kr397/ece4760-AroundSound/docs/images/parts_list.jpg

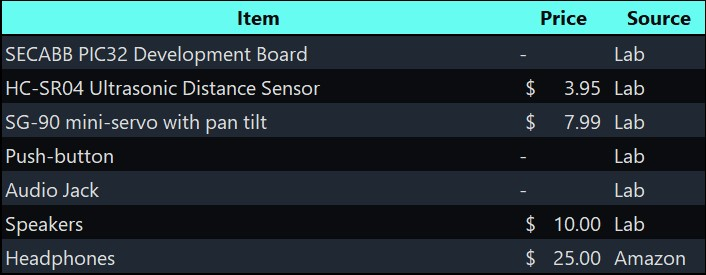
docs/images/parts_list.jpg
