kr397/ece4760-AroundSound/docs/images/form-factor.jpg

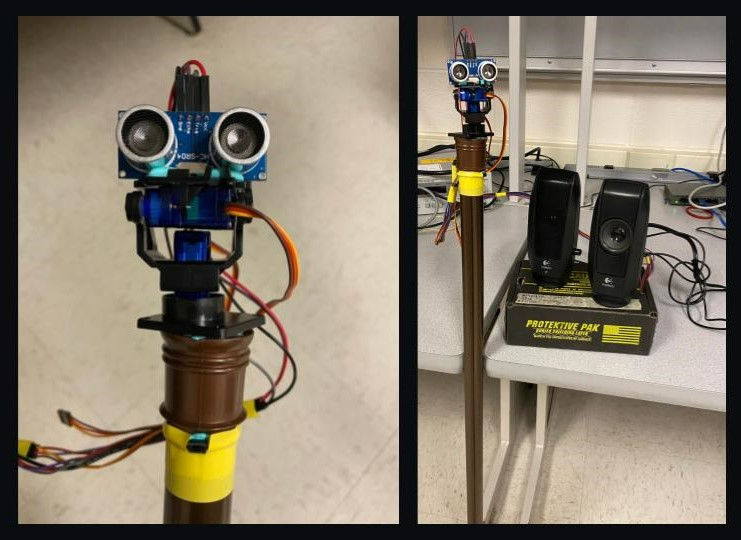
docs/images/form-factor.jpg
