kr397/ece4760-AroundSound/docs/images/3d audio.png

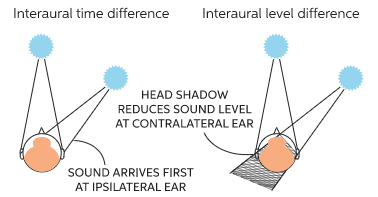
docs/images/3d audio.png
