kr397/ece4760-AroundSound/docs/images/FM_envelope.png

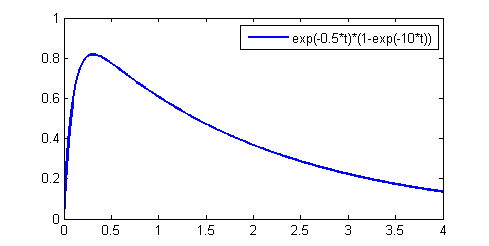
docs/images/FM_envelope.png
