kr397/ece4760-AroundSound/docs/images/Gradient.jpg

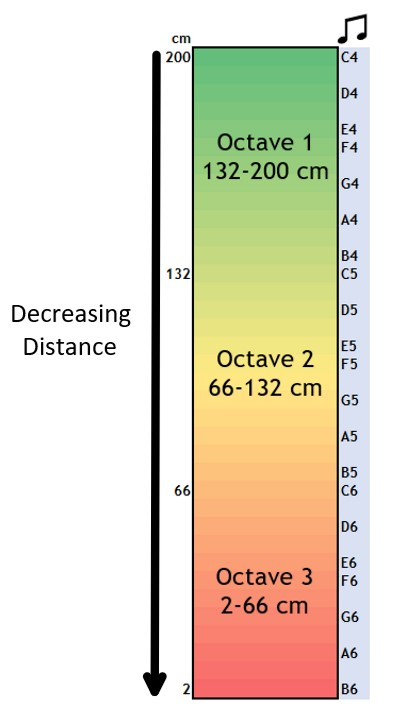
docs/images/Gradient.jpg
