kr397/ece4760-AroundSound/docs/images/pwm_motor.jpg

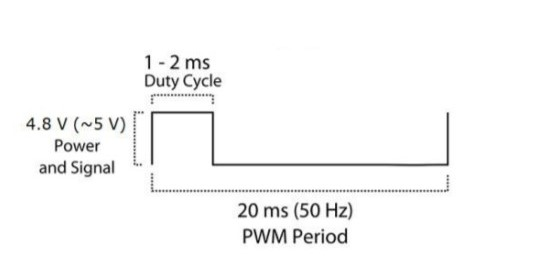
docs/images/pwm_motor.jpg
