kr397/ece4760-AroundSound/docs/images/stick-full.jpg

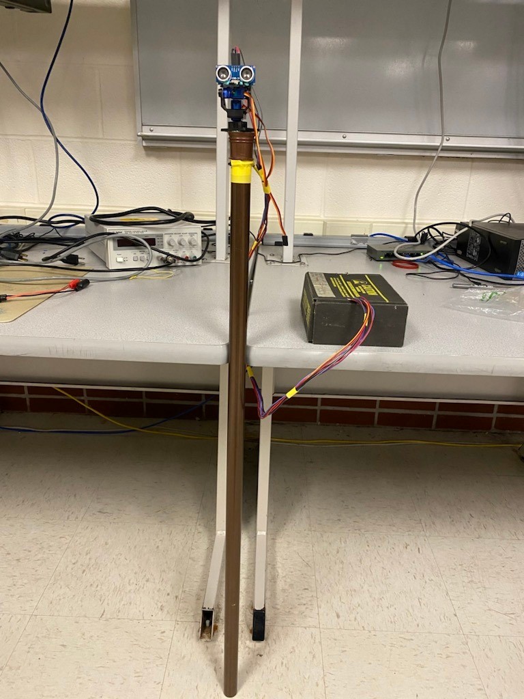
docs/images/stick-full.jpg
