kr397/ece4760-AroundSound/docs/images/timeline.png

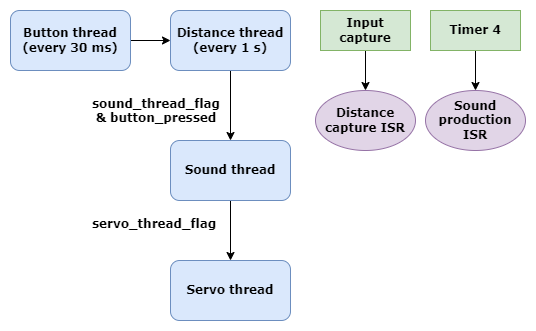
docs/images/timeline.png
