kr397/ece4760-AroundSound/docs/Circuit_schematic.pdf

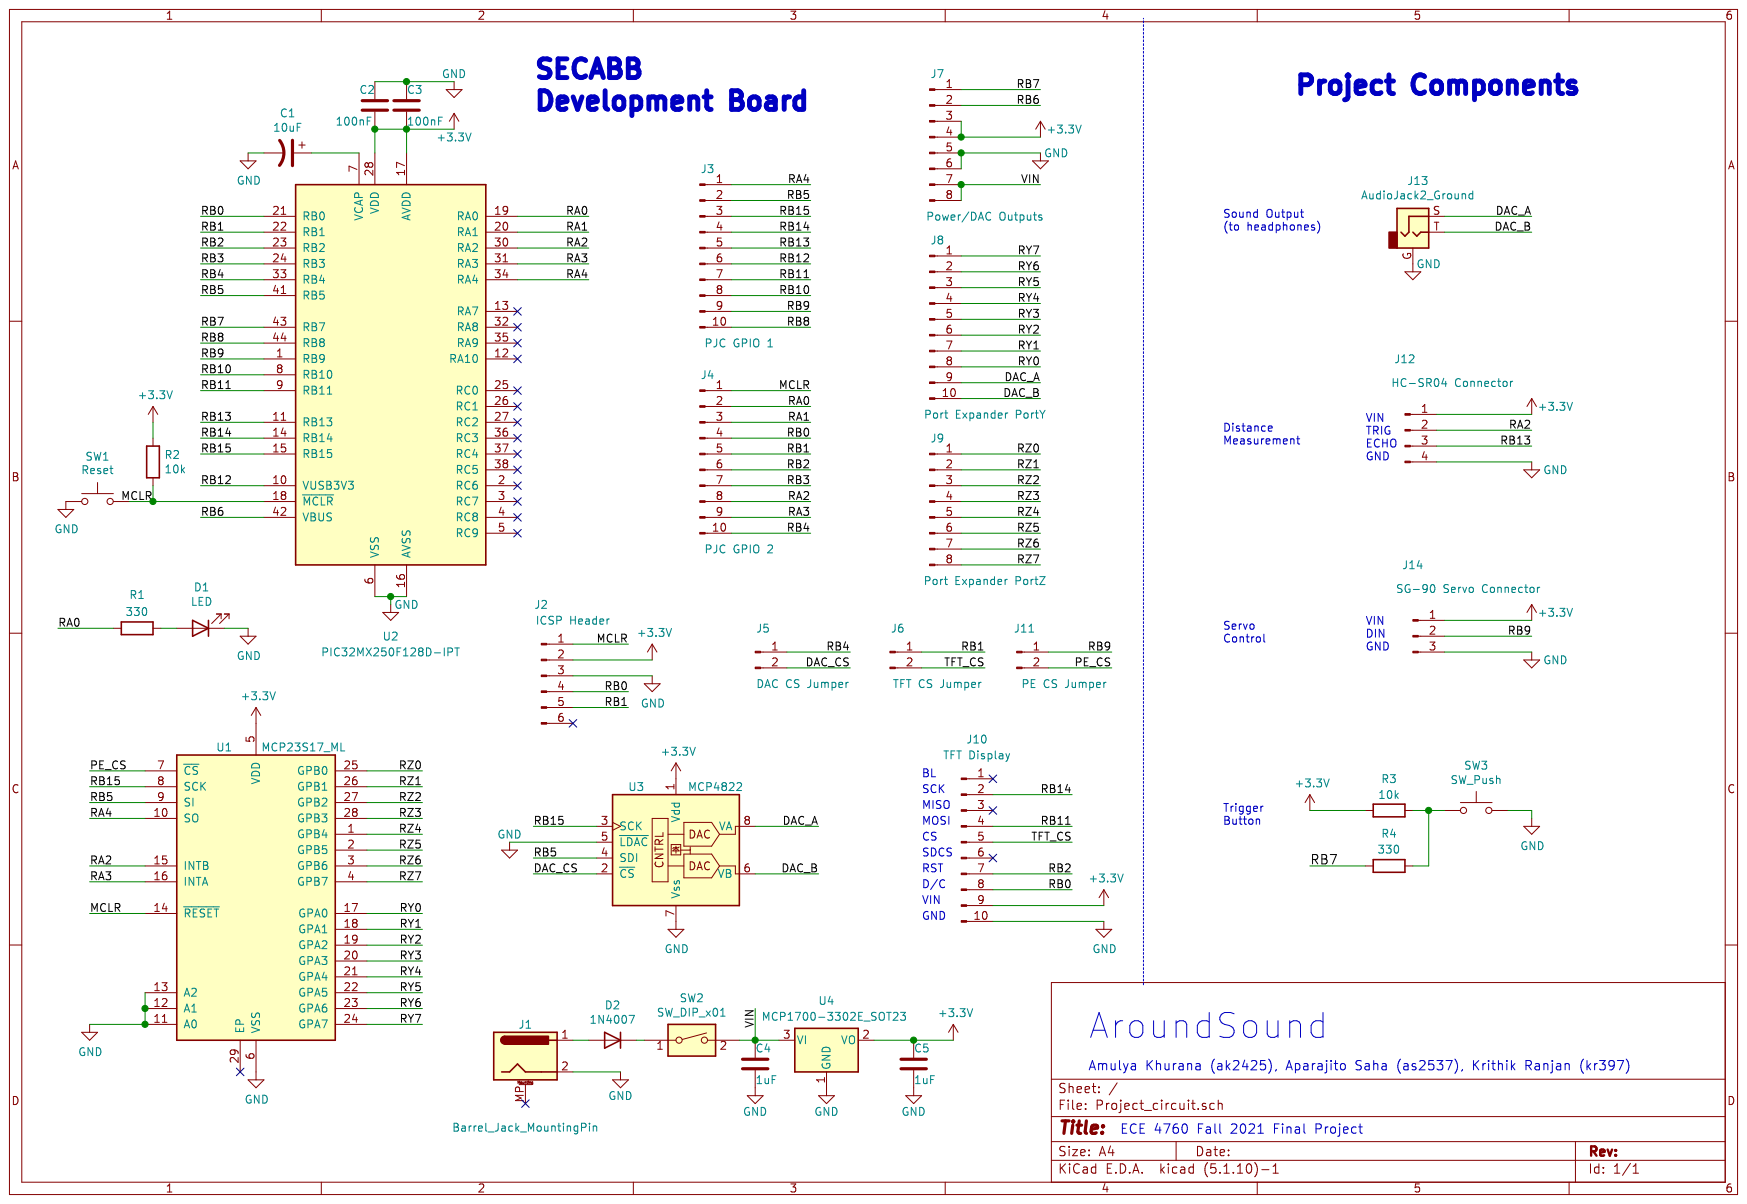
[picture p9: page 1]
