kr397/ece4760-AroundSound/docs/Project_circuit.sch

## KiCad design docs/Project_circuit.sch (2021-12-14)

Schematic: Project_circuit.sch

Parts:
C1: 10uF
C2, C3: 100nF
C4, C5: 1uF
D1: LED
D2: 1N4007; D_DO-41_SOD81_P10.16mm_Horizontal
J1: Barrel_Jack_MountingPin
J2: ICSP Header
J3: PJC GPIO 1
J4: PJC GPIO 2
J5: DAC CS Jumper
J6: TFT CS Jumper
J7: Power/DAC Outputs
J8: Port Expander PortY
J9: Port Expander PortZ
J10: TFT Display
J11: PE CS Jumper
J12: HC-SR04 Connector
J13: AudioJack2_Ground
J14: SG-90 Servo Connector
R1, R4: 330
R2, R3: 10k
SW1: Reset
SW2: SW_DIP_x01
SW3: SW_Push
U1: MCP23S17_ML; QFN-28-1EP_6x6mm_P0.65mm_EP4.25x4.25mm
U2: PIC32MX250F128D-IPT; TQFP-44_10x10mm_P0.8mm
U3: MCP4822
U4: MCP1700-3302E_SOT23; SOT-23

Notes on the sheet:
SCK
MISO
MOSI
SDCS
RST
D/C
VIN
GND
SECABB Development Board
Project Components
Sound Output (to headphones)
VIN TRIG ECHO GND
VIN DIN GND
Distance Measurement
Servo Control
AroundSound
Amulya Khurana (ak2425), Aparajito Saha (as2537), Krithik Ranjan (kr397)
ECE 4760 Fall 2021 Final Project
Trigger Button
