kr397/ece4760-AroundSound/(commit log)

2021-12-14 Changed directory
    [Project_circuit.sch]
2021-12-14 Made into github page
    [Project_circuit.sch]
